oxidecomputer/hw-gimletlet/docs/hirose-df9-41s.png

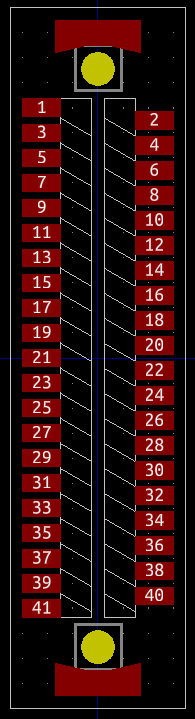
docs/hirose-df9-41s.png
