oxidecomputer/hw-gimletlet/docs/gimletlet-mechanical.pdf

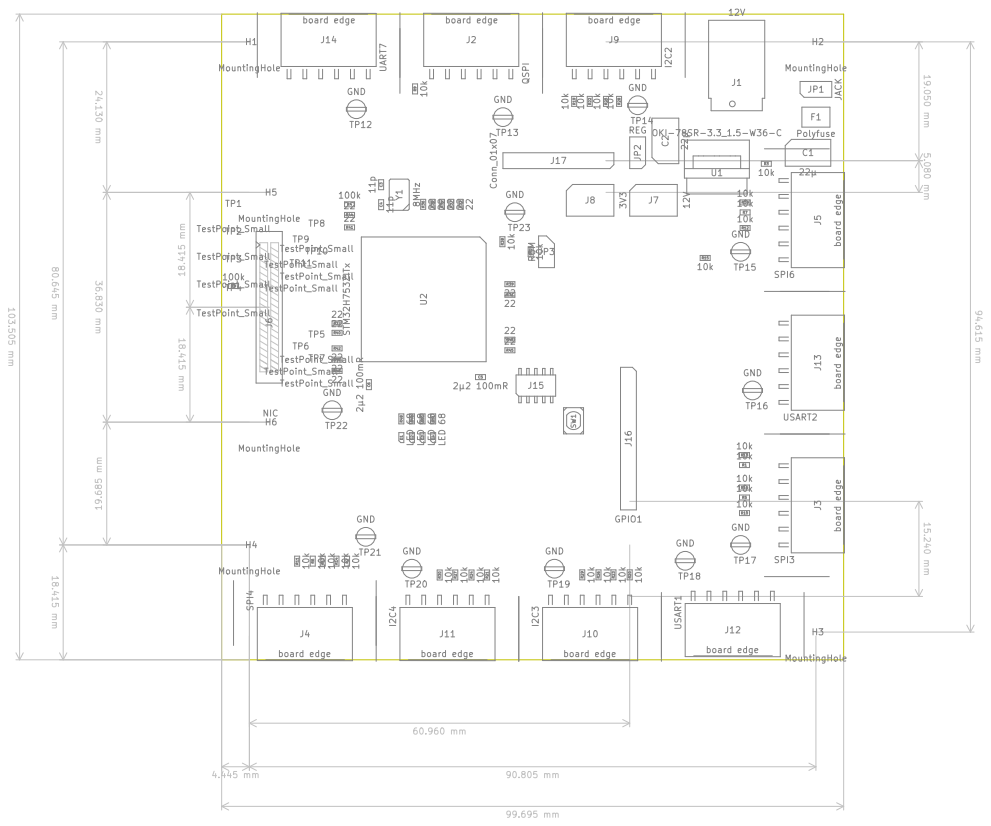
[picture p5: page 1]
