oxidecomputer/hw-gimletlet/gimletlet1/gimletlet.kicad_pcb

## KiCad design gimletlet1/gimletlet.kicad_pcb (2023-02-28)

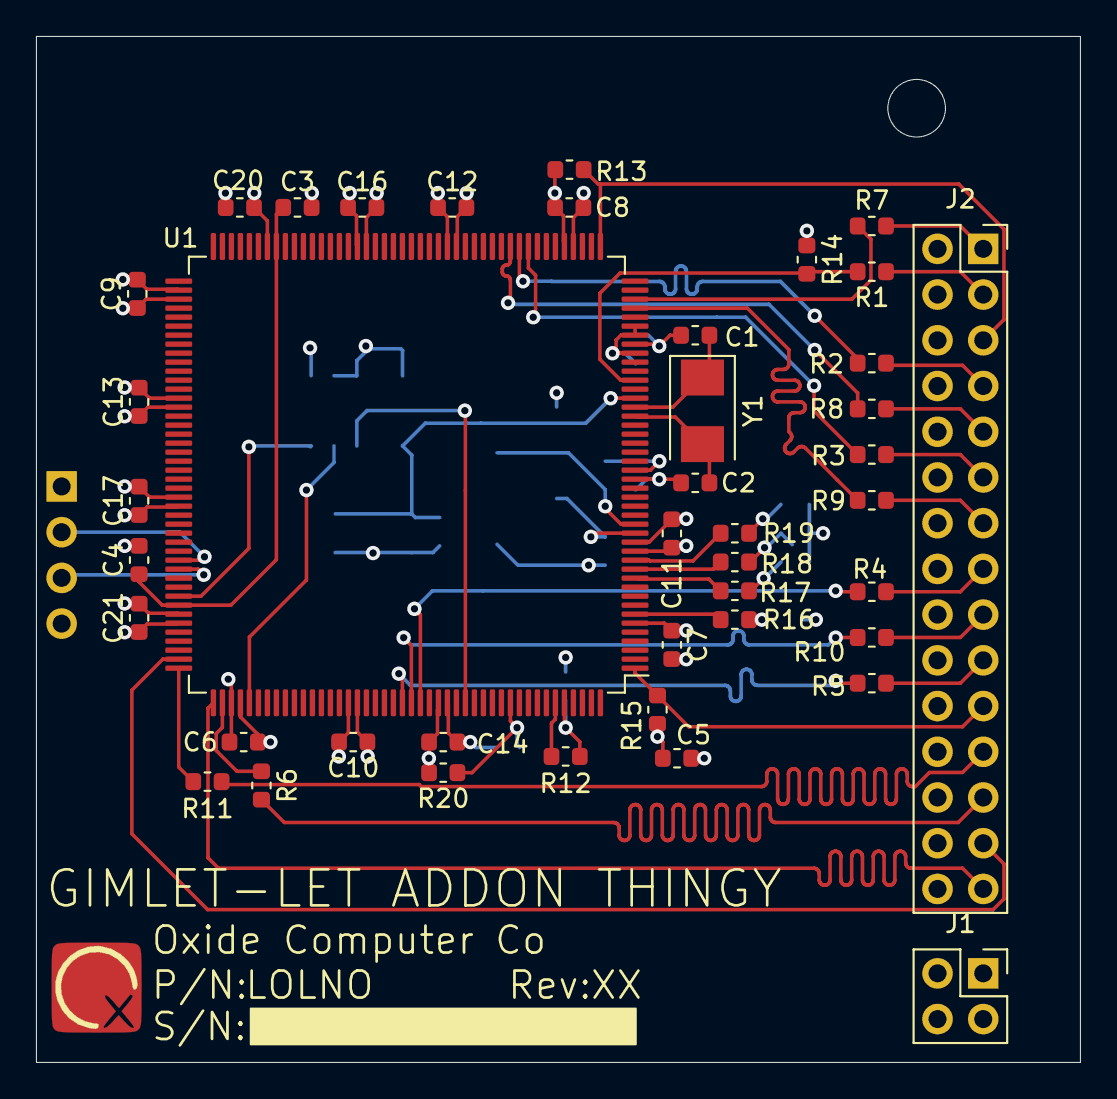
[picture p6: board gimletlet1/gimletlet.kicad_pcb from above]

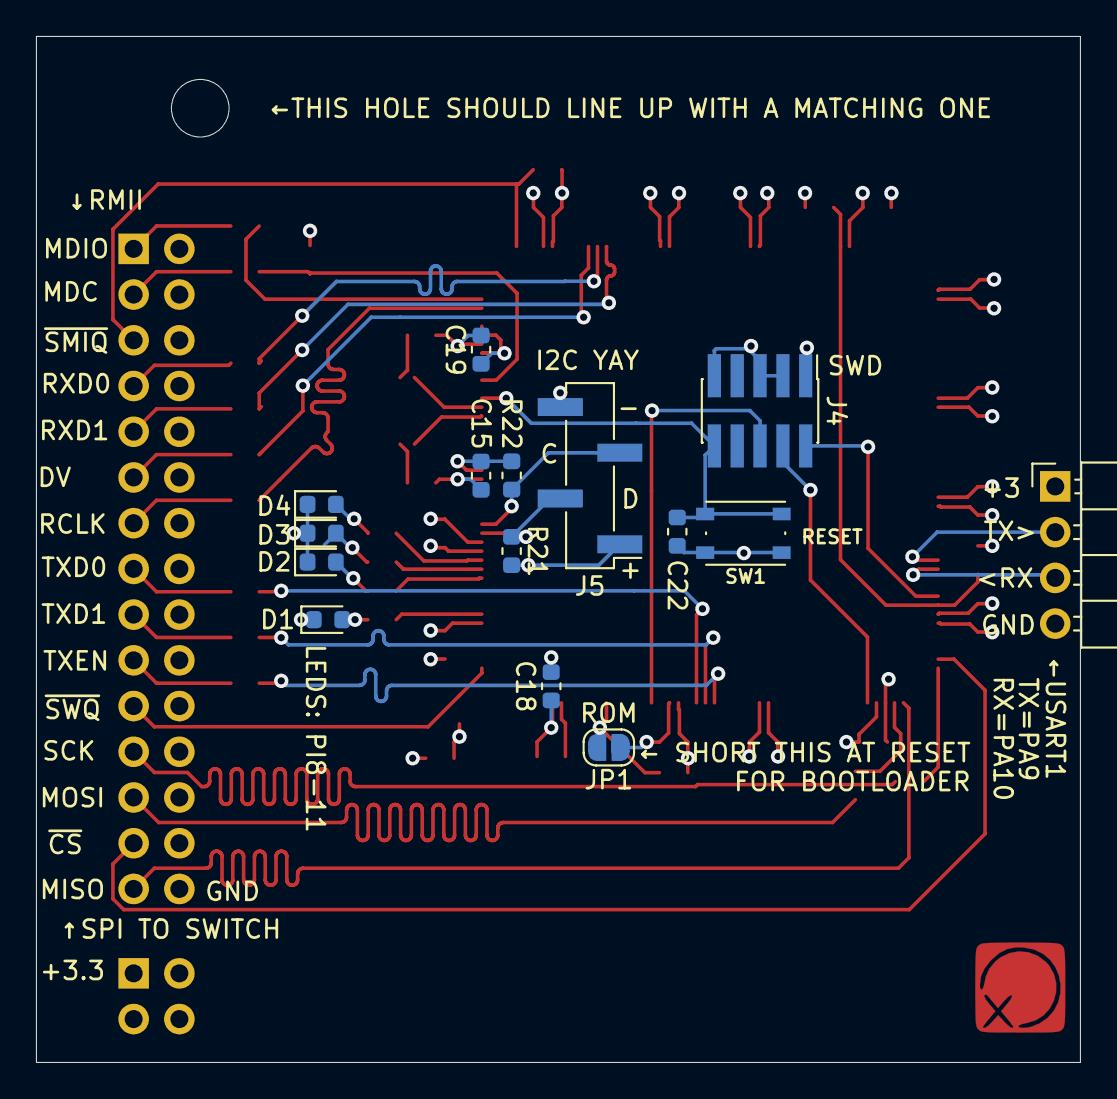
[picture p7: board gimletlet1/gimletlet.kicad_pcb from below]

Board: 4 copper layers, 58.0 x 57.0 mm, 59 parts (16 on the bottom side), 49 nets.

Parts:
C1, C2: 11p; C_0603_1608Metric
C3, C4: 2µ2 100mR; C_0603_1608Metric
C5: 4µ7; C_0603_1608Metric
C6, C7, C8, C9, C10, C11, C12, C13, C14, C15, C16, C17, C18, C19, C20, C21, C22: 0µ1; C_0603_1608Metric
D1, D2, D3, D4: LED; LED_0603_1608Metric
FID1: LOLNO; Oxide_Board_Identifier_33x7mm
H1: MountingHole; MountingHole_3.2mm_M3
J1: Conn_02x16_Odd_Even; PinSocket_2x02_P2.54mm_Vertical
J2: Conn_02x15_Odd_Even; PinSocket_2x15_P2.54mm_Vertical
J3: Conn_01x04; PinHeader_1x04_P2.54mm_Horizontal
J4: SWD; PinHeader_2x05_P1.27mm_Vertical_SMD
J5: I2C; PinHeader_1x04_P2.54mm_Vertical_SMD_Pin1Left
JP1: ROM; SolderJumper-2_P1.3mm_Open_RoundedPad1.0x1.5mm
R1, R2, R3, R4, R5, R6, R7, R8, R9, R10, R11: 22; R_0603_1608Metric
R12, R20, R21, R22: 10k; R_0603_1608Metric
R13, R14, R15: 100k; R_0603_1608Metric
R16, R17, R18, R19: 68; R_0603_1608Metric
SW1: RESET; PTS815
U1: STM32H753IITx; LQFP-176_24x24mm_P0.5mm
Y1: 8MHz; Crystal_SMD_5032-2Pin_5.0x3.2mm

Connections:
+3V3: C5.1, C6.1, C7.1, C8.1, C9.1, C10.1, C11.1, C12.1, C13.1, C14.1, C15.1, C16.1, C17.1, C18.1, C19.1, C20.1, C21.1, J1.1, J1.3, J3.1, J4.1, J5.1, JP1.1, R12.2, R13.1, R14.1, R15.1, R21.2, R22.2, U1.6, U1.15, U1.23, U1.36, U1.38, U1.39, U1.49, U1.62, U1.72, U1.82, U1.91, U1.103, U1.114, U1.127, U1.136, U1.149, U1.159, U1.172
/BOOT0: JP1.2, R20.1, U1.166
/LED0: R16.2, U1.7
/LED1: R17.2, U1.11
/LED2: R18.2, U1.12
/LED3: R19.2, U1.13
/MDC: R1.1, R14.2, U1.33
/MDIO: R7.1, U1.42
/OSC_IN: C2.1, U1.29, Y1.2
/OSC_OUT: C1.1, U1.30, Y1.1
/RMII_CRS_DV: R3.1, U1.53
/RMII_REF_CLK: R9.1, U1.41
/RMII_RXD0: R2.1, U1.54
/RMII_RXD1: R8.1, U1.55
/RMII_TXD0: R4.1, U1.156
/RMII_TXD1: R10.1, U1.155
/RMII_TXEN: R5.1, U1.154
/SCL: J5.3, R22.1, U1.17
/SDA: J5.2, R21.1, U1.16
/SPI2_MISO: J2.29, U1.133
/SPI2_MOSI: R6.1, U1.134
/SPI2_SCK: R11.1, U1.132
/SWCLK: J4.4, U1.137
/SWDIO: J4.2, U1.124
/SWO: J4.6, U1.161
/USART1_RX: J3.3, U1.121
/USART1_TX: J3.2, U1.120
/X_MDC: J2.3, R1.2
/X_MDIO: J2.1, R7.2
/X_RMII_CRS_DV: J2.11, R3.2
/X_RMII_REFCLK: J2.13, R9.2
/X_RMII_RXD0: J2.7, R2.2
/X_RMII_RXD1: J2.9, R8.2
/X_RMII_TXD0: J2.15, R4.2
/X_RMII_TXD1: J2.17, R10.2
/X_RMII_TXEN: J2.19, R5.2
/X_SPI_MOSI: J2.25, R6.2
/X_SPI_SCK: J2.23, R11.2
/~RST: C22.1, J4.10, SW1.1, U1.31
/~SMI_IRQ: J2.5, R13.2, U1.45
/~SPI2_CS0: J2.27, U1.131
/~SW_IRQ: J2.21, R15.2, U1.1
GND: C1.2, C2.2, C3.2, C4.2, C5.2, C6.2, C7.2, C8.2, C9.2, C10.2, C11.2, C12.2, C13.2, C14.2, C15.2, C16.2, C17.2, C18.2, C19.2, C20.2, C21.2, C22.2, D1.1, D2.1, D3.1, D4.1, J2.2, J2.4, J2.6, J2.8, J2.10, J2.12, J2.14, J2.16, J2.18, J2.20, J2.22, J2.24, J2.26, J2.28, J2.30, J3.4, J4.3, J4.5, J4.9, J5.4, R20.2, SW1.2, U1.14, U1.22, U1.37, U1.48, U1.61, U1.71, U1.90, U1.102, U1.113, U1.126, U1.135, U1.148, U1.158
unnamed: C3.1, C4.1, U1.81, U1.125
unnamed: D1.2, R16.1
unnamed: D2.2, R17.1
unnamed: D3.2, R18.1
unnamed: D4.2, R19.1
unnamed: R12.1, U1.171
