oxidecomputer/hw-gimletlet/gimletlet.kicad_pcb

## KiCad design gimletlet.kicad_pcb (2023-02-28)

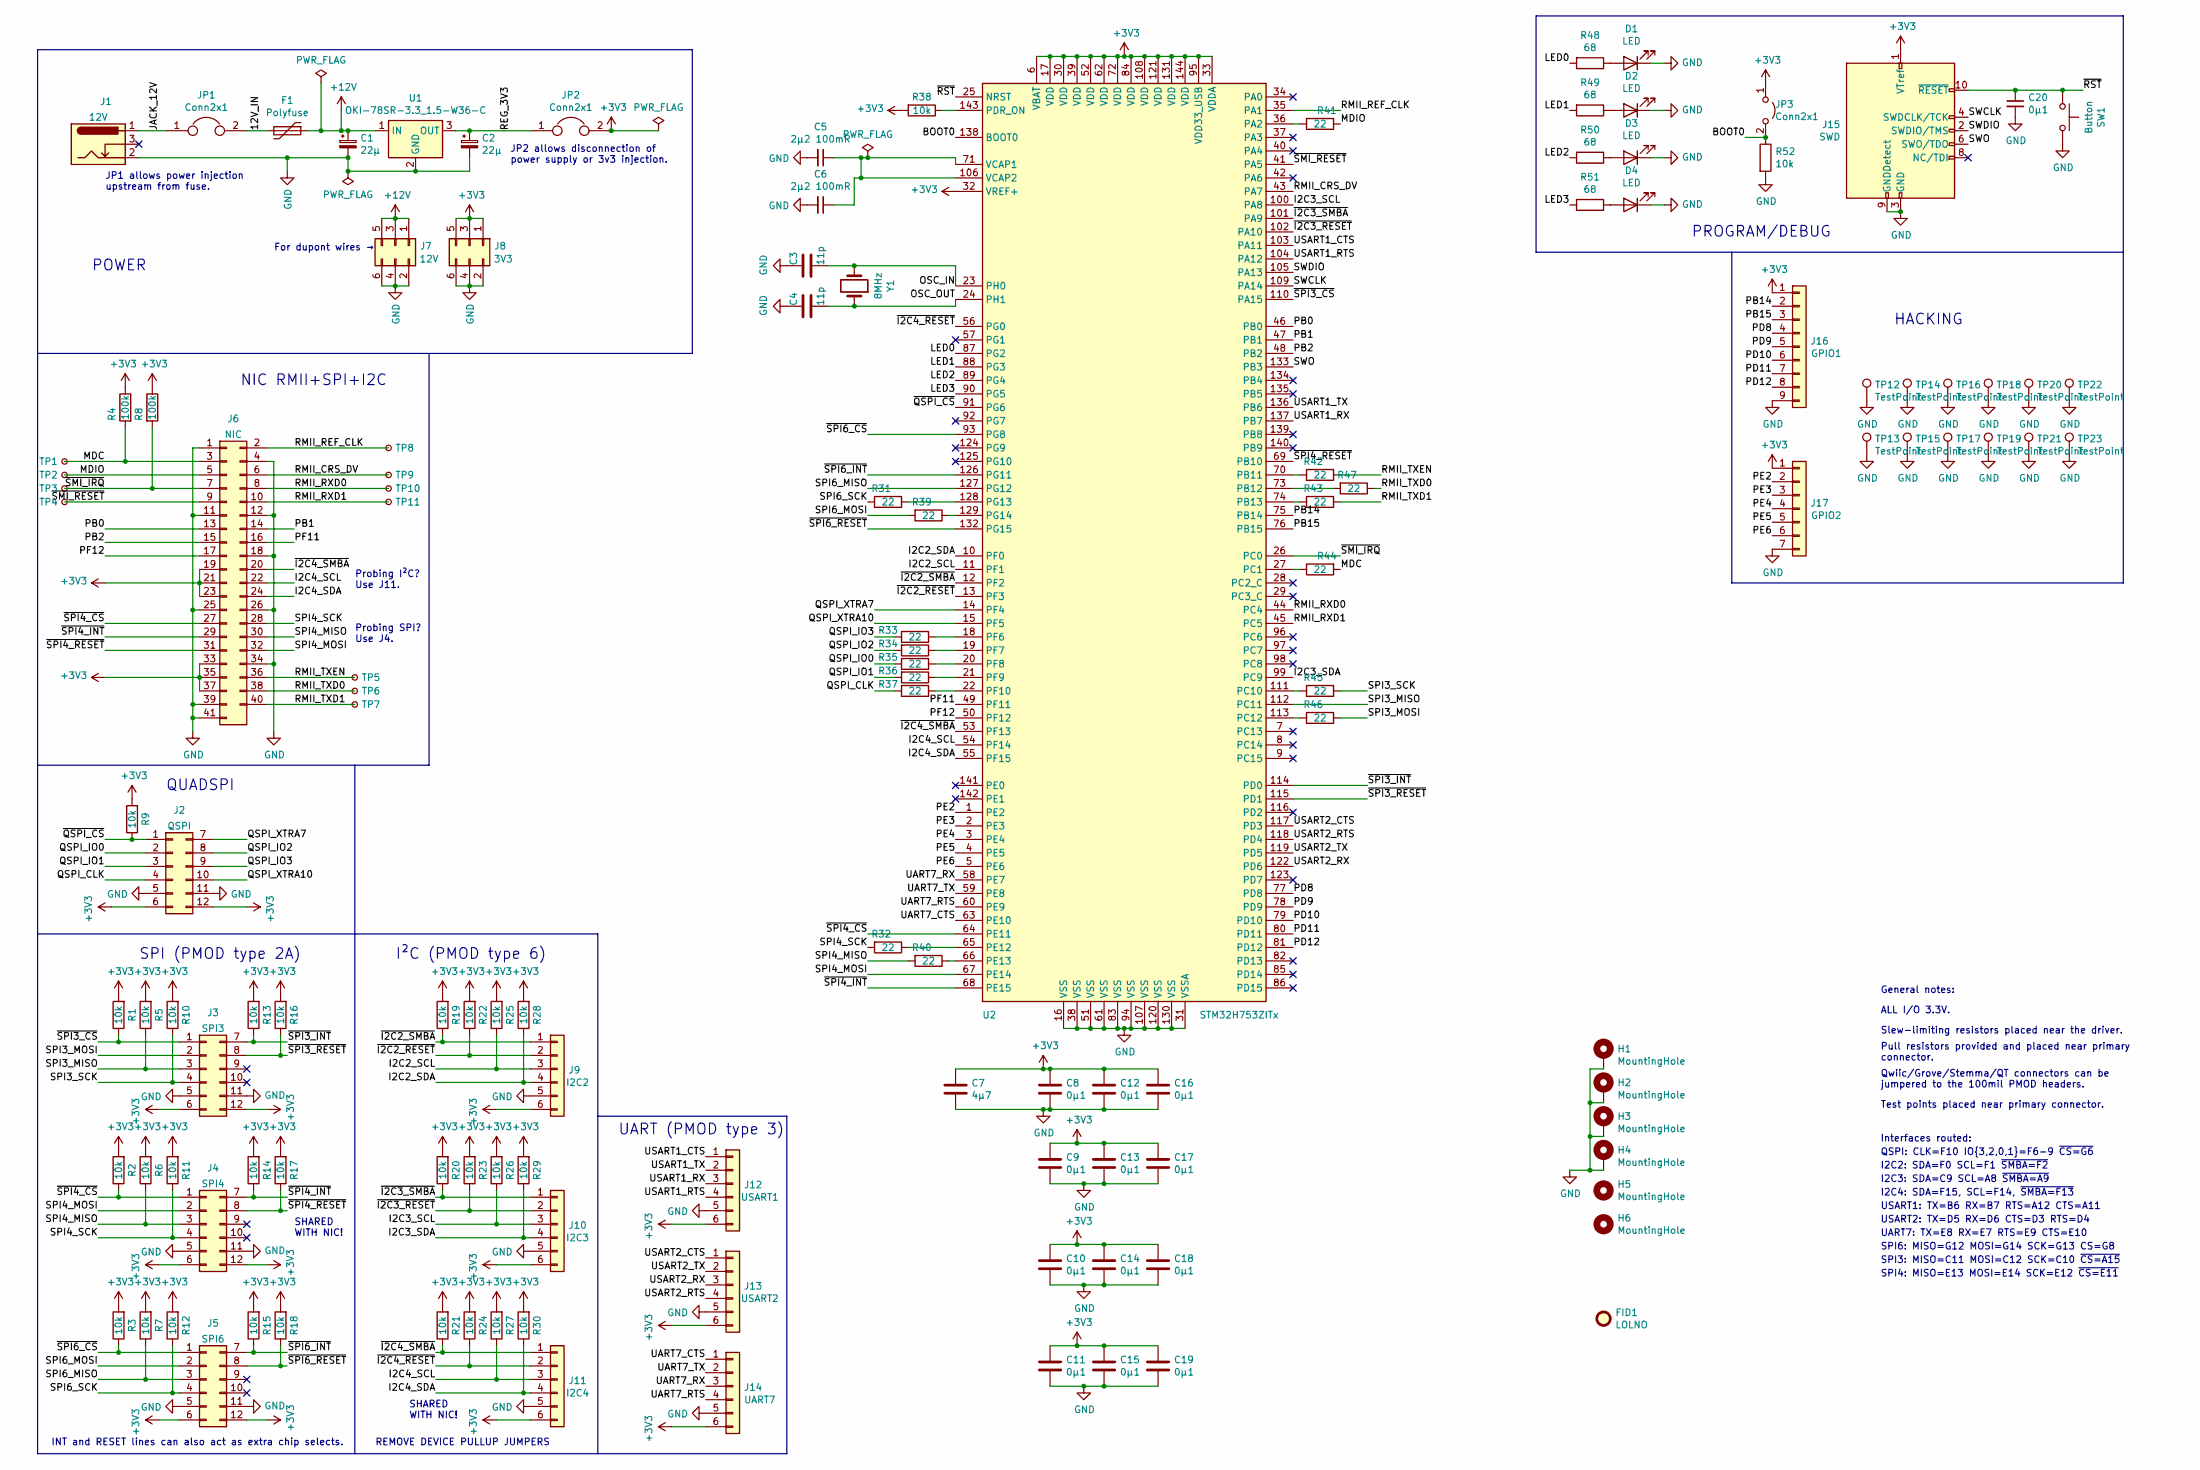
[picture p8: schematic gimletlet.kicad_sch, Gimlet-let addon thingy]

Parts:
C1, C2: 22µ; CP_EIA-7343-31_Kemet-D; MPN T491D226K020AT7280
C3, C4: 11p; C_0603_1608Metric; MPN C0603C110J5GACTU
C5, C6: 2µ2 100mR; C_0603_1608Metric; MPN C0603C225K4PACTU
C7: 4µ7; C_0603_1608Metric; MPN CL10A475KQ8NNNC
C8, C9, C10, C11, C12, C13, C14, C15, C16, C17, C18, C19, C20: 0µ1; C_0603_1608Metric; MPN C0603C104M4RACTU
D1: LED; LED_0603_1608Metric; MPN 150060RS75000
D2: LED; LED_0603_1608Metric; MPN 150060AS75000
D3: LED; LED_0603_1608Metric; MPN 150060GS75000
D4: LED; LED_0603_1608Metric; MPN 150060BS75000
F1: Polyfuse; Fuse_1812_4532Metric; MPN 1812L200/16DR
FID1: LOLNO; Oxide_Board_Identifier_33x7mm
H1, H2, H3, H4: MountingHole; MountingHole_3.2mm_M3_Pad_Via
H5, H6: MountingHole; MountingHole_3.2mm_M3
J1: BarrelJack; BarrelJack_CUI_PJ-036AH-SMT_Horizontal; MPN PJ-036AH-SMT-TR
J2, J3, J4, J5: Conn6x2; PMOD_12pin_host_horizontal; MPN PPTC062LJBN-RC
J6: Conn41x2; Hirose_DF9-41S-1V(69)_2Rows_41Pin-2MP_P1.0mm_Vertical; MPN DF9-41S-1V(32)
J7, J8: Conn3x2; PinSocket_2x03_P2.54mm_Vertical; MPN RS2-06-G
J9, J10, J11, J12, J13, J14: Conn6x1; PMOD_6pin_host_horizontal; MPN FR20206HBNN
J15: SWD; PinHeader_2x05_P1.27mm_Vertical_SMD; MPN FTSH-105-01-F-DV-K
J16: Conn9x1; PinSocket_1x09_P2.54mm_Vertical; MPN RS1-09-G
J17: Conn_01x07; PinSocket_1x07_P2.54mm_Vertical; MPN RS1-07-G
JP1, JP2: Conn2x1; PinHeader_1x02_P2.54mm_Vertical; MPN PH1-02-UA
JP3: Conn2x1; PinHeader_2x01_P2.54mm_Vertical; MPN PH1-02-UA
R1, R2, R3, R5, R6, R7, R9, R10, R11, R12, R13, R14, R15, R16, R17, R18, R19, R20, R21, R22, R23, R24, R25, R26, R27, R28, R29, R30, R38, R52: 10k; R_0603_1608Metric; MPN CR0603-JW-103ELF
R4, R8: 100k; R_0603_1608Metric; MPN CR0603-JW-104ELF
R31, R32, R33, R34, R35, R36, R37, R39, R40, R41, R42, R43, R44, R45, R46, R47: 22; R_0603_1608Metric; MPN CR0603-JW-220ELF
R48, R49, R50, R51: 68; R_0603_1608Metric; MPN CR0603-JW-680ELF
SW1: Button; PTS815; MPN PTS815 SJM 250 SMTR LFS
TP1, TP2, TP3, TP4, TP5, TP6, TP7, TP8, TP9, TP10, TP11: TestPoint_Small; TestPoint_THTPad_D2.0mm_Drill1.0mm
TP12, TP13, TP14, TP15, TP16, TP17, TP18, TP19, TP20, TP21, TP22, TP23: TestPoint; TestPoint_Loop_D3.50mm_Drill1.4mm_Beaded; MPN 5006
U1: OKI-78SR-3.3_1.5-W36-C; Converter_DCDC_muRata_OKI-78SR_Vertical; MPN OKI-78SR-3.3/1.5-W36-C
U2: STM32H753ZITx; LQFP-144_20x20mm_P0.5mm; MPN STM32H753ZIT6
Y1: 8MHz; Crystal_SMD_5032-2Pin_5.0x3.2mm; MPN ECS-80-12-30Q-DS-TR

Connections:
+3V3: C7.1, C8.1, C9.1, C10.1, C11.1, C12.1, C13.1, C14.1, C15.1, C16.1, C17.1, C18.1, C19.1, J2.6, J2.12, J3.6, J3.12, J4.6, J4.12, J5.6, J5.12, J6.19, J6.21, J6.23, J6.33, J6.35, J6.37, J8.1, J8.3, J8.5, J9.6, J10.6, J11.6, J12.6, J13.6, J14.6, J15.1 (VTref), J16.1, J17.1, JP2.2, JP3.1 (A), R1.2, R2.2, R3.2, R4.1, R5.2, R6.2, R7.2, R8.1, R9.2, R10.2, R11.2, R12.2, R13.2, R14.2, R15.2, R16.2, R17.2, R18.2, R19.2, R20.2, R21.2, R22.2, R23.2, R24.2, R25.2, R26.2, R27.2, R28.2, R29.2, R30.2, R38.2, U2.6 (VBAT), U2.17 (VDD), U2.30 (VDD), U2.32 (VREF+), U2.33 (VDDA), U2.39 (VDD), U2.52 (VDD), U2.62 (VDD), U2.72 (VDD), U2.84 (VDD), U2.95 (VDD33_USB), U2.108 (VDD), U2.121 (VDD), U2.131 (VDD), U2.144 (VDD)
+12V: C1.1, F1.1, J7.1, J7.3, J7.5, U1.1 (IN)
/12V_IN: F1.2, JP1.2
/BOOT0: JP3.2 (B), R52.1, U2.138 (BOOT0)
/I2C2_SCL: J9.3, R25.1, U2.11 (PF1)
/I2C2_SDA: J9.4, R28.1, U2.10 (PF0)
/I2C3_SCL: J10.3, R26.1, U2.100 (PA8)
/I2C3_SDA: J10.4, R29.1, U2.99 (PC9)
/I2C4_SCL: J6.22, J11.3, R27.1, U2.54 (PF14)
/I2C4_SDA: J6.24, J11.4, R30.1, U2.55 (PF15)
/JACK_12V: J1.1, JP1.1
/LED0: R48.2, U2.87 (PG2)
/LED1: R49.2, U2.88 (PG3)
/LED2: R50.2, U2.89 (PG4)
/LED3: R51.2, U2.90 (PG5)
/MDC: J6.3, R4.2, R44.2, TP1.1
/MDIO: J6.5, R41.2, TP2.1
/OSC_IN: C3.1, U2.23 (PH0), Y1.2
/OSC_OUT: C4.1, U2.24 (PH1), Y1.1
/PB0: J6.13, U2.46 (PB0)
/PB1: J6.14, U2.47 (PB1)
/PB2: J6.15, U2.48 (PB2)
/PB14: J16.2, U2.75 (PB14)
/PB15: J16.3, U2.76 (PB15)
/PD8: J16.4, U2.77 (PD8)
/PD9: J16.5, U2.78 (PD9)
/PD10: J16.6, U2.79 (PD10)
/PD11: J16.7, U2.80 (PD11)
/PD12: J16.8, U2.81 (PD12)
/PE2: J17.2, U2.1 (PE2)
/PE3: J17.3, U2.2 (PE3)
/PE4: J17.4, U2.3 (PE4)
/PE5: J17.5, U2.4 (PE5)
/PE6: J17.6, U2.5 (PE6)
/PF11: J6.16, U2.49 (PF11)
/PF12: J6.17, U2.50 (PF12)
/QSPI_CLK: J2.4, R37.2
/QSPI_IO0: J2.2, R35.2
/QSPI_IO1: J2.3, R36.2
/QSPI_IO2: J2.8, R34.2
/QSPI_IO3: J2.9, R33.2
/QSPI_XTRA7: J2.7, U2.14 (PF4)
/QSPI_XTRA10: J2.10, U2.15 (PF5)
/REG_3V3: C2.1, JP2.1, U1.3 (OUT)
/RMII_CRS_DV: J6.6, TP9.1, U2.43 (PA7)
/RMII_REF_CLK: J6.2, TP8.1, U2.35 (PA1)
/RMII_RXD0: J6.8, TP10.1, U2.44 (PC4)
/RMII_RXD1: J6.10, TP11.1, U2.45 (PC5)
/RMII_TXD0: J6.38, R47.1, TP6.1
/RMII_TXD1: J6.40, R43.1, TP7.1
/RMII_TXEN: J6.36, R42.1, TP5.1
/SPI3_MISO: J3.3, R5.1, U2.112 (PC11)
/SPI3_MOSI: J3.2, R46.1
/SPI3_SCK: J3.4, R10.1, R45.1
/SPI4_MISO: J4.3, J6.30, R6.1, R40.2
/SPI4_MOSI: J4.2, J6.32, U2.67 (PE14)
/SPI4_SCK: J4.4, J6.28, R11.1, R32.2
/SPI6_MISO: J5.3, R7.1, U2.127 (PG12)
/SPI6_MOSI: J5.2, R39.2
/SPI6_SCK: J5.4, R12.1, R31.2
/SWCLK: J15.4 (SWDCLK/TCK), U2.109 (PA14)
/SWDIO: J15.2 (SWDIO/TMS), U2.105 (PA13)
/SWO: J15.6 (SWO/TDO), U2.133 (PB3)
/UART7_CTS: J14.1, U2.63 (PE10)
/UART7_RTS: J14.4, U2.60 (PE9)
/UART7_RX: J14.3, U2.58 (PE7)
/UART7_TX: J14.2, U2.59 (PE8)
/USART1_CTS: J12.1, U2.103 (PA11)
/USART1_RTS: J12.4, U2.104 (PA12)
/USART1_RX: J12.3, U2.137 (PB7)
/USART1_TX: J12.2, U2.136 (PB6)
/USART2_CTS: J13.1, U2.117 (PD3)
/USART2_RTS: J13.4, U2.118 (PD4)
/USART2_RX: J13.3, U2.122 (PD6)
/USART2_TX: J13.2, U2.119 (PD5)
/~I2C2_RESET: J9.2, R22.1, U2.13 (PF3)
/~I2C2_SMBA: J9.1, R19.1, U2.12 (PF2)
/~I2C3_RESET: J10.2, R23.1, U2.102 (PA10)
/~I2C3_SMBA: J10.1, R20.1, U2.101 (PA9)
/~I2C4_RESET: J11.2, R24.1, U2.56 (PG0)
/~I2C4_SMBA: J6.20, J11.1, R21.1, U2.53 (PF13)
/~QSPI_CS: J2.1, R9.1, U2.91 (PG6)
/~RST: C20.1, J15.10 (~RESET), SW1.1, U2.25 (NRST)
/~SMI_IRQ: J6.7, R8.2, TP3.1, U2.26 (PC0)
/~SMI_RESET: J6.9, TP4.1, U2.41 (PA5)
/~SPI3_CS: J3.1, R1.1, U2.110 (PA15)
/~SPI3_INT: J3.7, R13.1, U2.114 (PD0)
/~SPI3_RESET: J3.8, R16.1, U2.115 (PD1)
/~SPI4_CS: J4.1, J6.27, R2.1, U2.64 (PE11)
/~SPI4_INT: J4.7, J6.29, R14.1, U2.68 (PE15)
/~SPI4_RESET: J4.8, J6.31, R17.1, U2.69 (PB10)
/~SPI6_CS: J5.1, R3.1, U2.93 (PG8)
/~SPI6_INT: J5.7, R15.1, U2.126 (PG11)
/~SPI6_RESET: J5.8, R18.1, U2.132 (PG15)
GND: C1.2, C2.2, C3.2, C4.2, C5.2, C6.2, C7.2, C8.2, C9.2, C10.2, C11.2, C12.2, C13.2, C14.2, C15.2, C16.2, C17.2, C18.2, C19.2, C20.2, D1.1 (K), D2.1 (K), D3.1 (K), D4.1 (K), H1.1, H2.1, H3.1, H4.1, J1.2, J2.5, J2.11, J3.5, J3.11, J4.5, J4.11, J5.5, J5.11, J6.1, J6.4, J6.11, J6.12, J6.18, J6.25, J6.26, J6.34, J6.39, J6.41, J7.2, J7.4, J7.6, J8.2, J8.4, J8.6, J9.5, J10.5, J11.5, J12.5, J13.5, J14.5, J15.3 (GND), J15.5 (GND), J15.9 (GNDDetect), J16.9, J17.7, R52.2, SW1.2, TP12.1, TP13.1, TP14.1, TP15.1, TP16.1, TP17.1, TP18.1, TP19.1, TP20.1, TP21.1, TP22.1, TP23.1, U1.2 (GND), U2.16 (VSS), U2.31 (VSSA), U2.38 (VSS), U2.51 (VSS), U2.61 (VSS), U2.83 (VSS), U2.94 (VSS), U2.107 (VSS), U2.120 (VSS), U2.130 (VSS)
unnamed: C5.1, C6.1, U2.71 (VCAP1), U2.106 (VCAP2)
unnamed: D1.2 (A), R48.1
unnamed: D2.2 (A), R49.1
unnamed: D3.2 (A), R50.1
unnamed: D4.2 (A), R51.1
unnamed: R31.1, U2.128 (PG13)
unnamed: R32.1, U2.65 (PE12)
unnamed: R33.1, U2.18 (PF6)
unnamed: R34.1, U2.19 (PF7)
unnamed: R35.1, U2.20 (PF8)
unnamed: R36.1, U2.21 (PF9)
unnamed: R37.1, U2.22 (PF10)
unnamed: R38.1, U2.143 (PDR_ON)
unnamed: R39.1, U2.129 (PG14)
unnamed: R40.1, U2.66 (PE13)
unnamed: R41.1, U2.36 (PA2)
unnamed: R42.2, U2.70 (PB11)
unnamed: R43.2, U2.74 (PB13)
unnamed: R44.1, U2.27 (PC1)
unnamed: R45.2, U2.111 (PC10)
unnamed: R46.2, U2.113 (PC12)
unnamed: R47.2, U2.73 (PB12)

Notes on the sheet:
POWER
SPI4: MISO=E13 MOSI=E14 SCK=E12 ~{CS=E11}
Probing I²C? Use J11.
Slew-limiting resistors placed near the driver.
SPI (PMOD type 2A)
JP2 allows disconnection of power supply or 3v3 injection.
QUADSPI
JP1 allows power injection upstream from fuse.
Test points placed near primary connector.
ALL I/O 3.3V.
SHARED WITH NIC!
REMOVE DEVICE PULLUP JUMPERS
Pull resistors provided and placed near primary connector.
Qwiic/Grove/Stemma/QT connectors can be jumpered to the 100mil PMOD headers.
I2C3: SDA=C9 SCL=A8 ~{SMBA=A9}
SPI6: MISO=G12 MOSI=G14 SCK=G13 CS=G8
Probing SPI? Use J4.
SPI3: MISO=C11 MOSI=C12 SCK=C10 ~{CS=A15}
QSPI: CLK=F10 IO{3,2,0,1}=F6-9 ~{CS=G6}
INT and RESET lines can also act as extra chip selects.
I2C4: SDA=F15, SCL=F14, ~{SMBA=F13}
I²C (PMOD type 6)
UART (PMOD type 3)
USART2: TX=D5 RX=D6 CTS=D3 RTS=D4
USART1: TX=B6 RX=B7 RTS=A12 CTS=A11
NIC RMII+SPI+I2C
Interfaces routed:
For dupont wires →
HACKING
General notes:
PROGRAM/DEBUG
I2C2: SDA=F0 SCL=F1 ~{SMBA=F2}
UART7: TX=E8 RX=E7 RTS=E9 CTS=E10

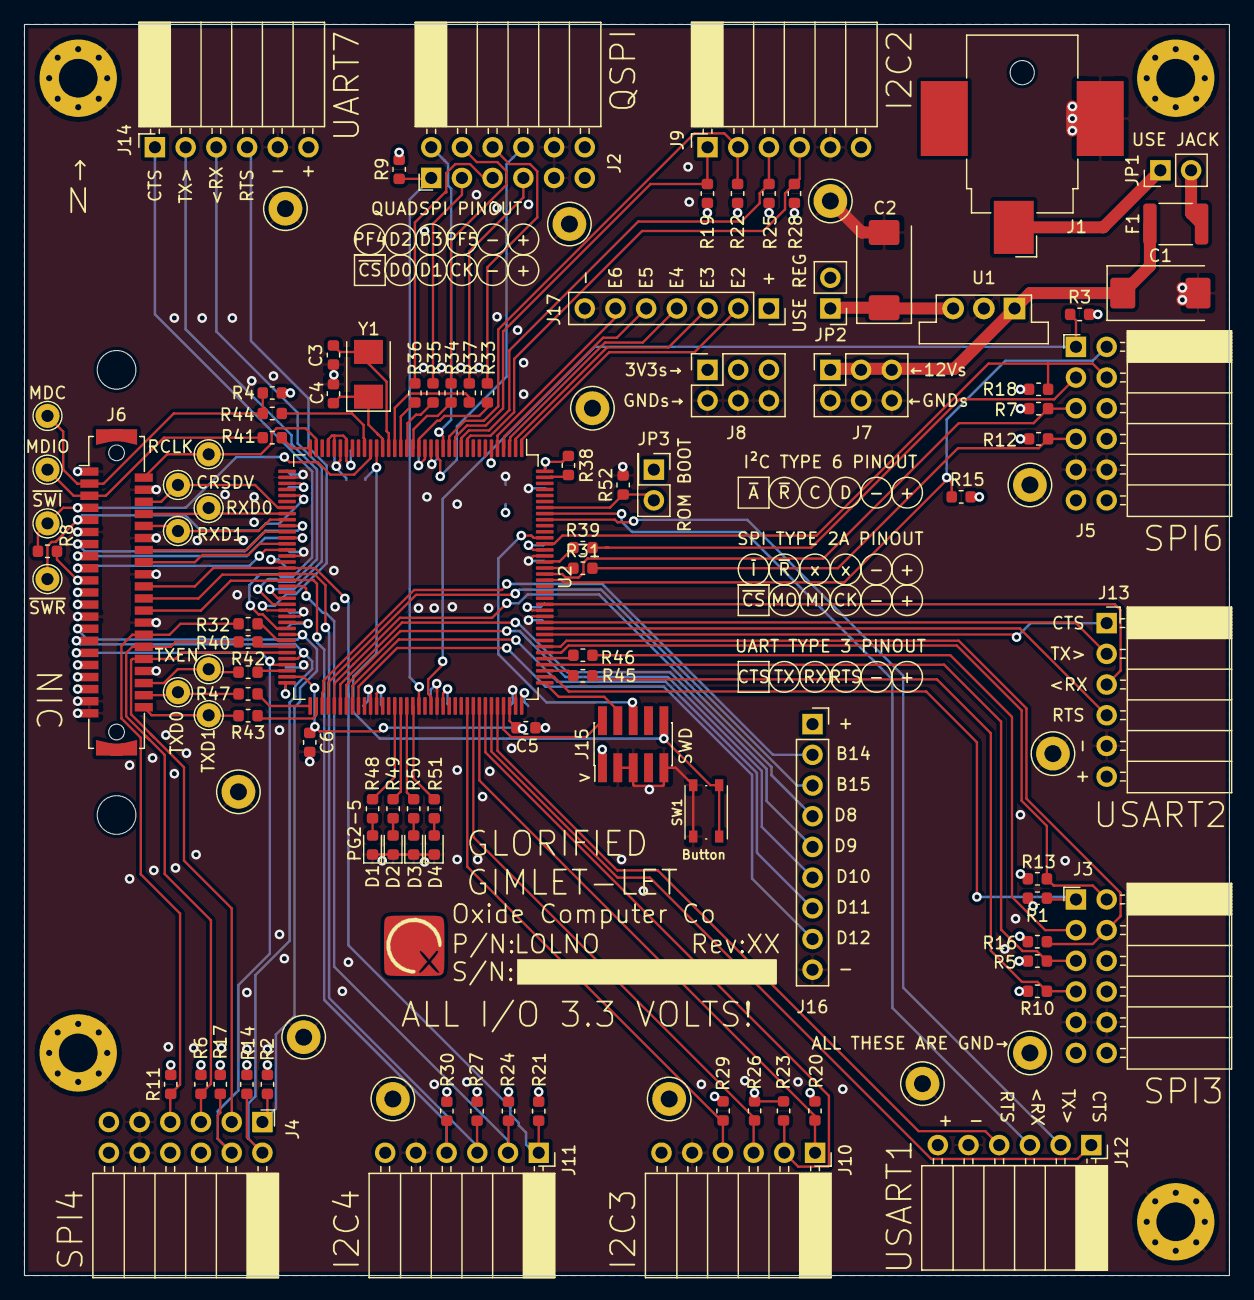
[picture p9: board gimletlet.kicad_pcb from above]

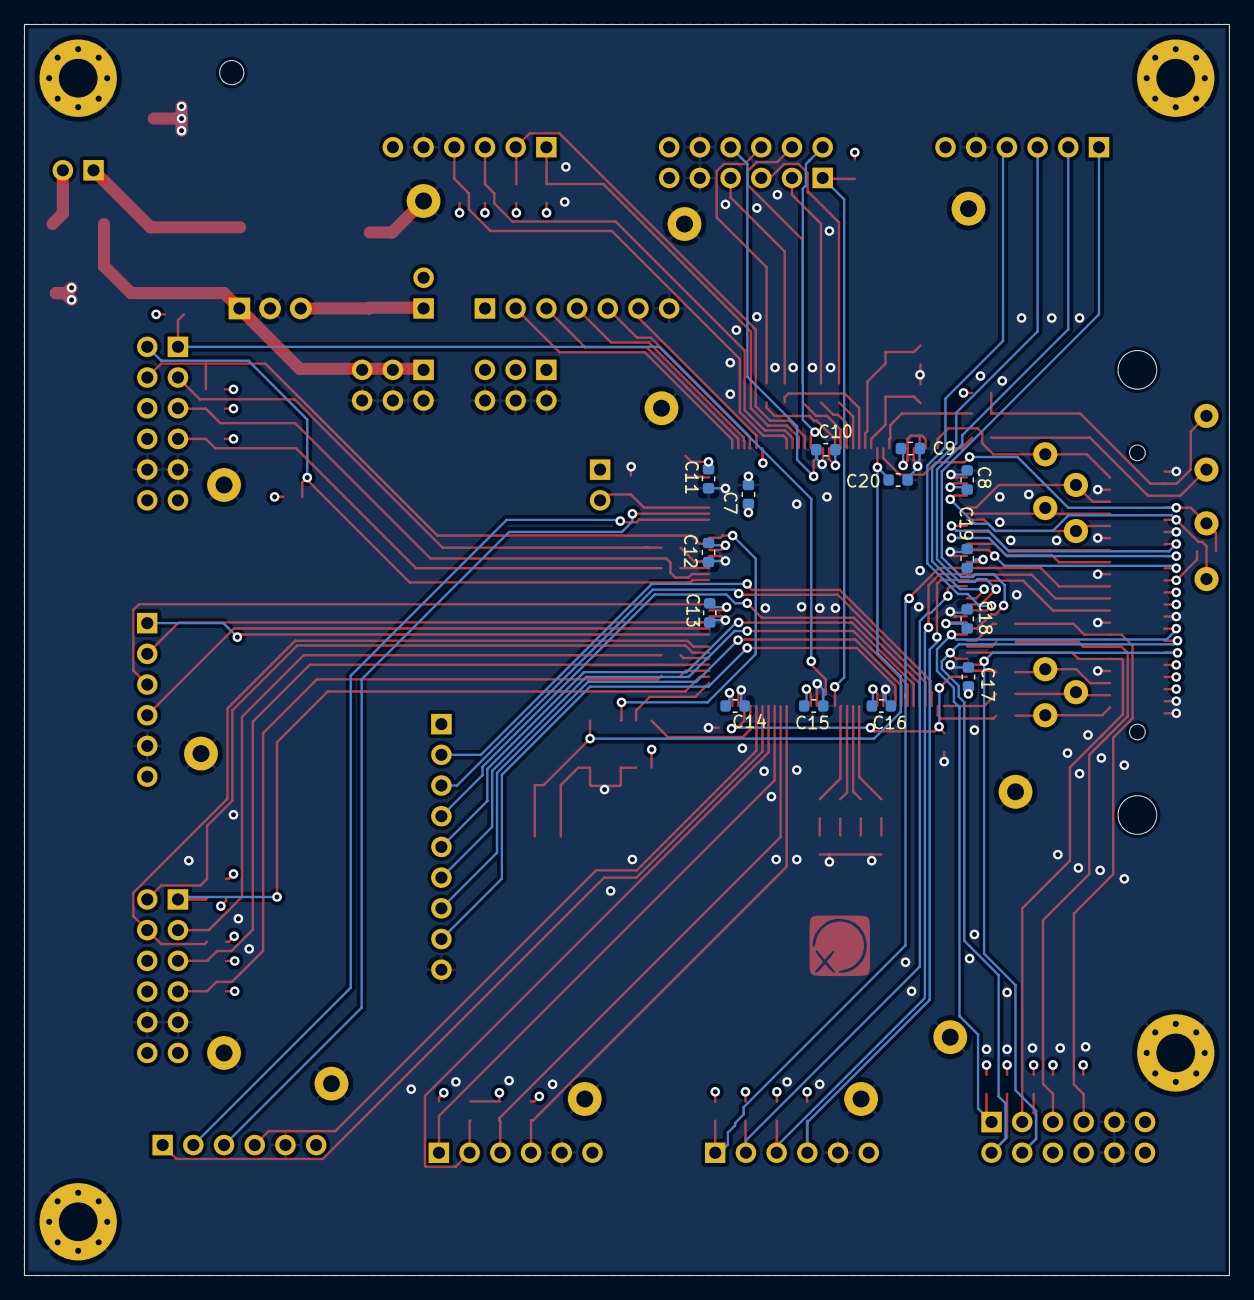
[picture p10: board gimletlet.kicad_pcb from below]

Board: 4 copper layers, 99.7 x 103.5 mm, 131 parts (14 on the bottom side), 117 nets.
